davidvillarreal2901/Digital-II/documentacion/diagramas/ArquitecturaSoC.jpg

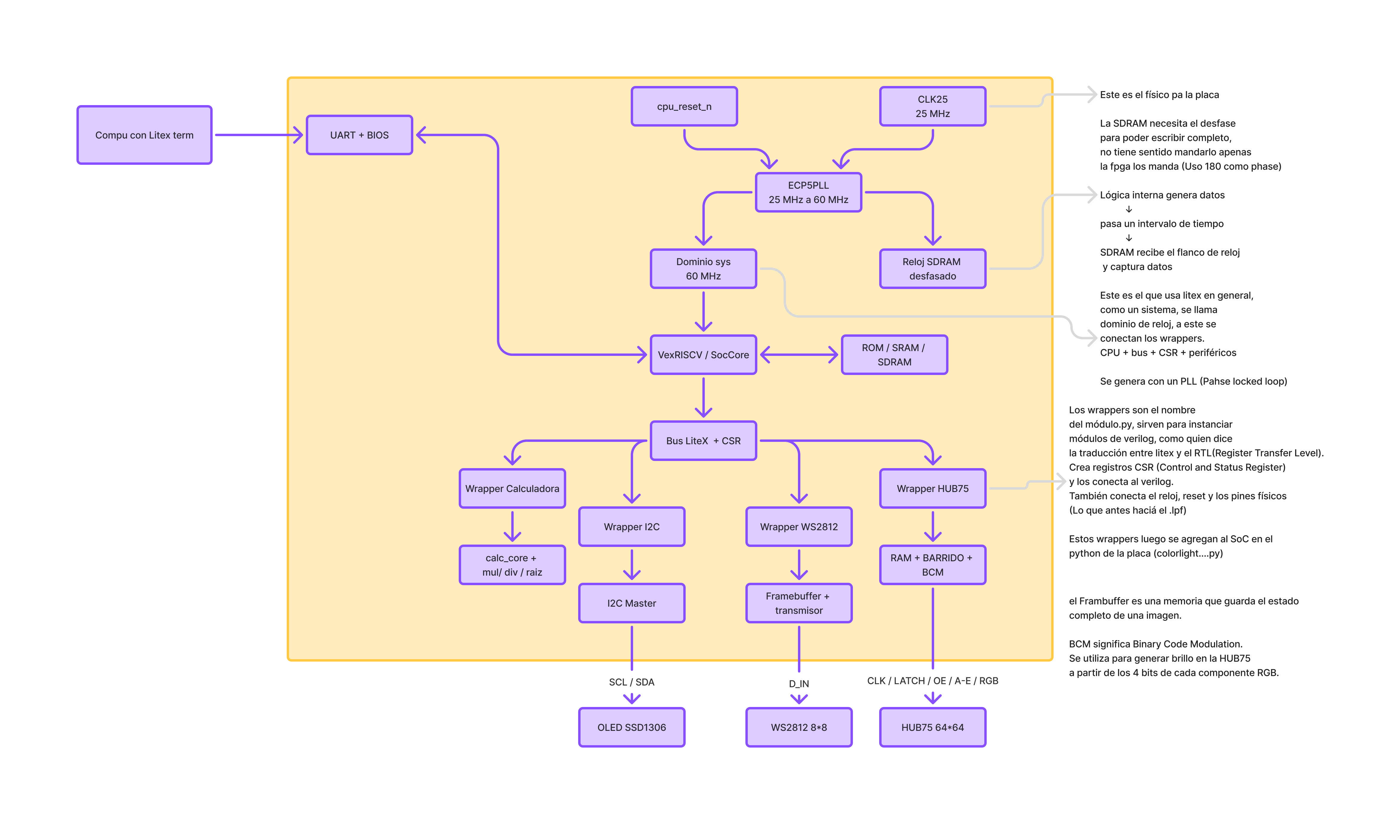
documentacion/diagramas/ArquitecturaSoC.jpg
