davidvillarreal2901/Digital-II/documentacion/diagramas/Calculadora/Calculadora_flujo.jpg

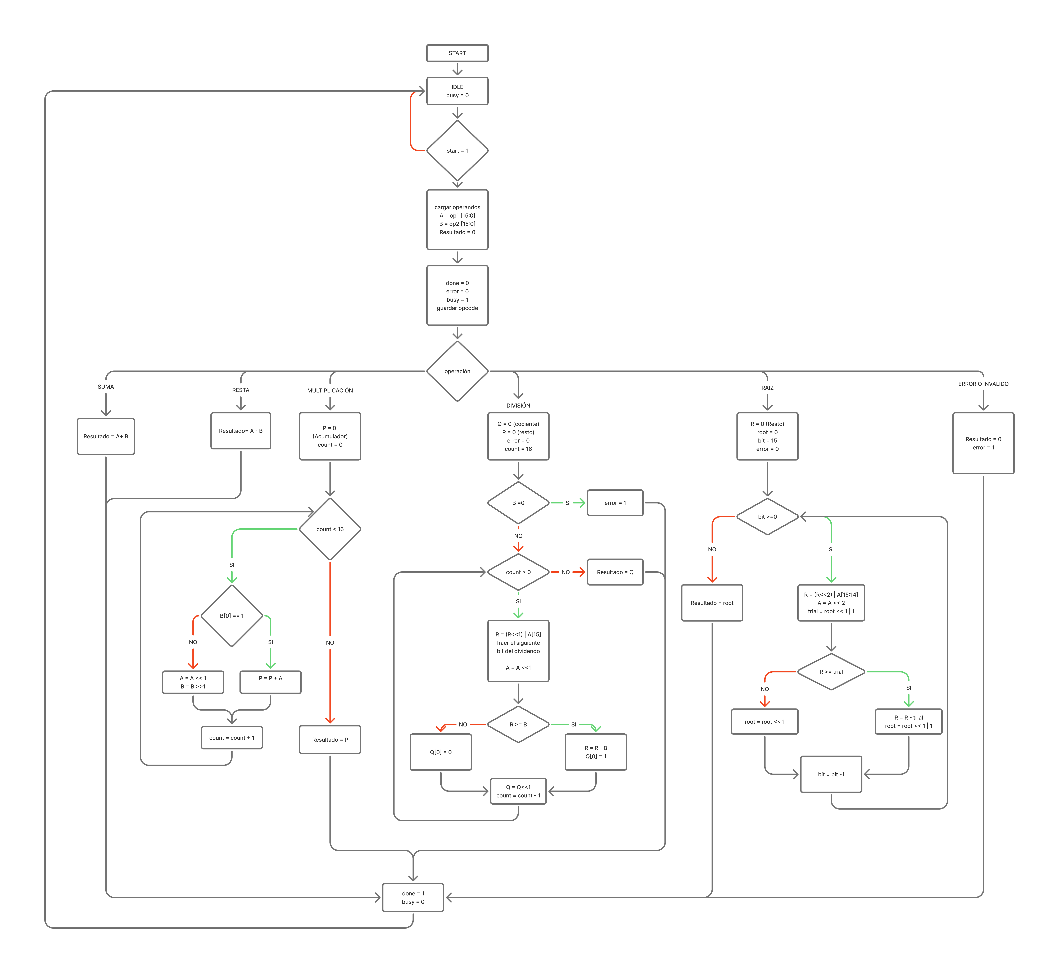
documentacion/diagramas/Calculadora/Calculadora_flujo.jpg
