davidvillarreal2901/Digital-II/documentacion/diagramas/Estructura Repo.jpg

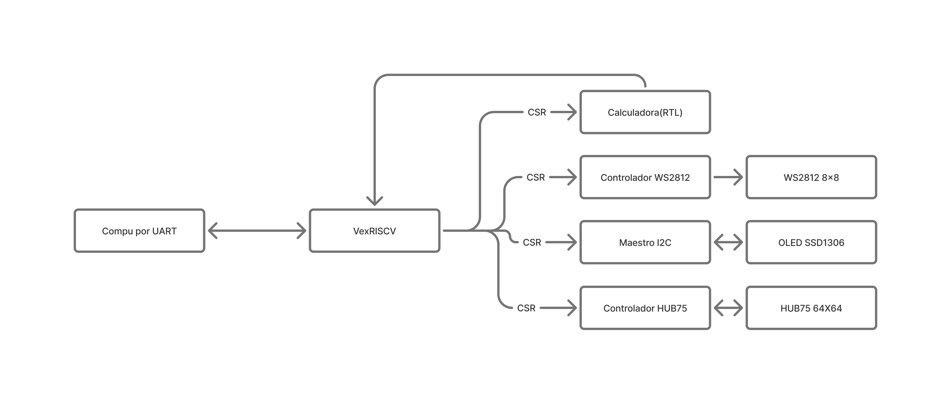
documentacion/diagramas/Estructura Repo.jpg
