davidvillarreal2901/Digital-II/documentacion/diagramas/Flujo firmware interactivo.jpg

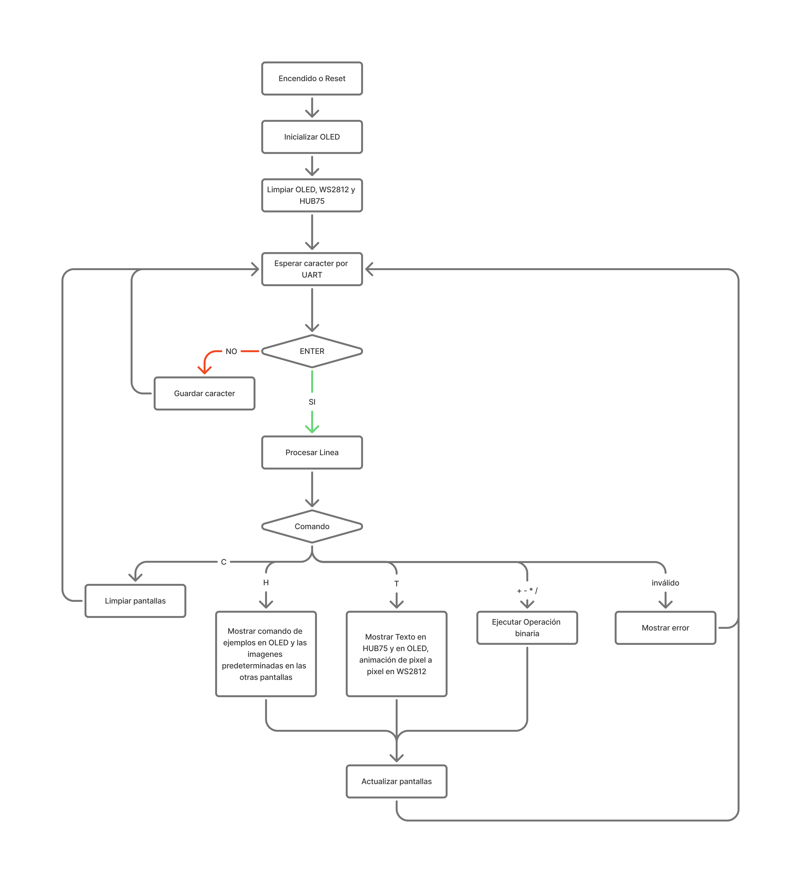
documentacion/diagramas/Flujo firmware interactivo.jpg
