davidvillarreal2901/Digital-II/documentacion/diagramas/I2C/i2c.jpg

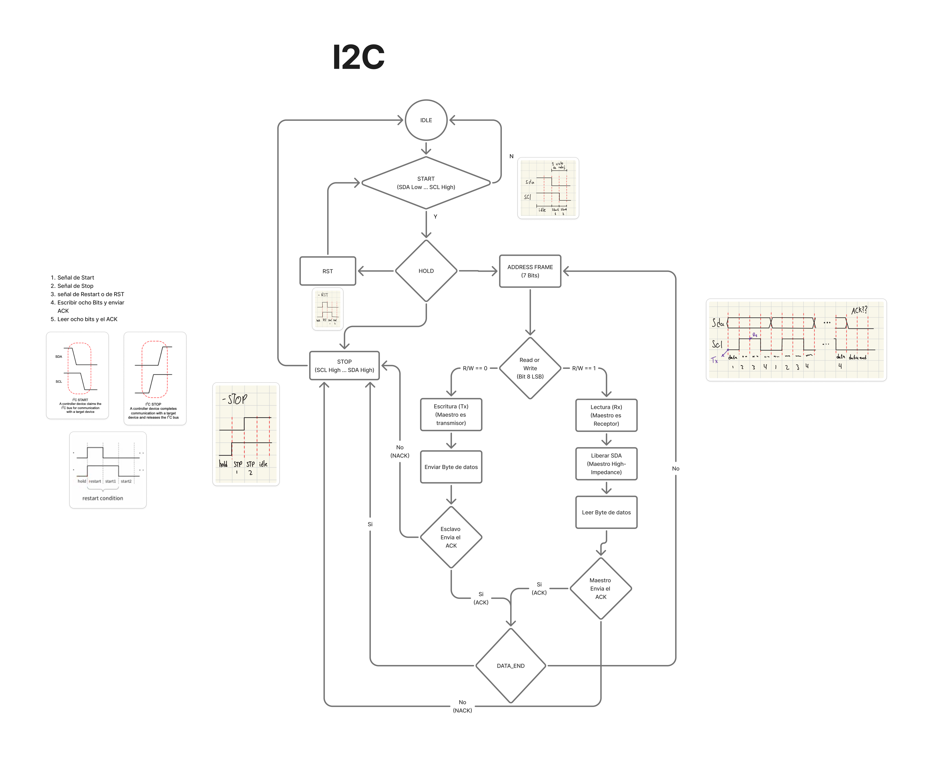
documentacion/diagramas/I2C/i2c.jpg
