davidvillarreal2901/Digital-II/documentacion/diagramas/ws2812/WS2812_estados.jpg

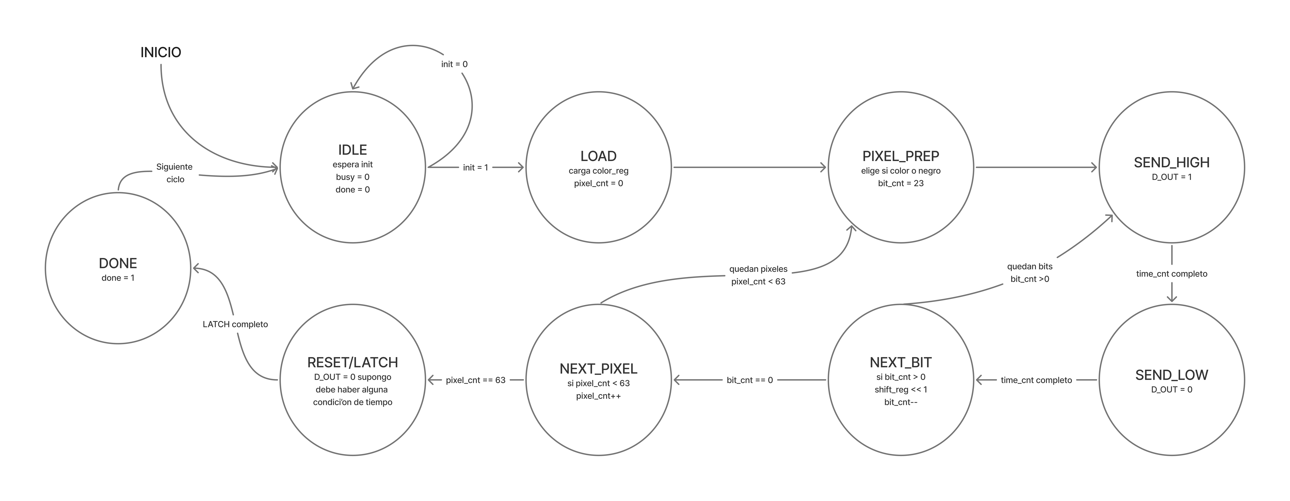
documentacion/diagramas/ws2812/WS2812_estados.jpg
