davidvillarreal2901/Digital-II/documentacion/diagramas/ws2812/WS2812_flujo.jpg

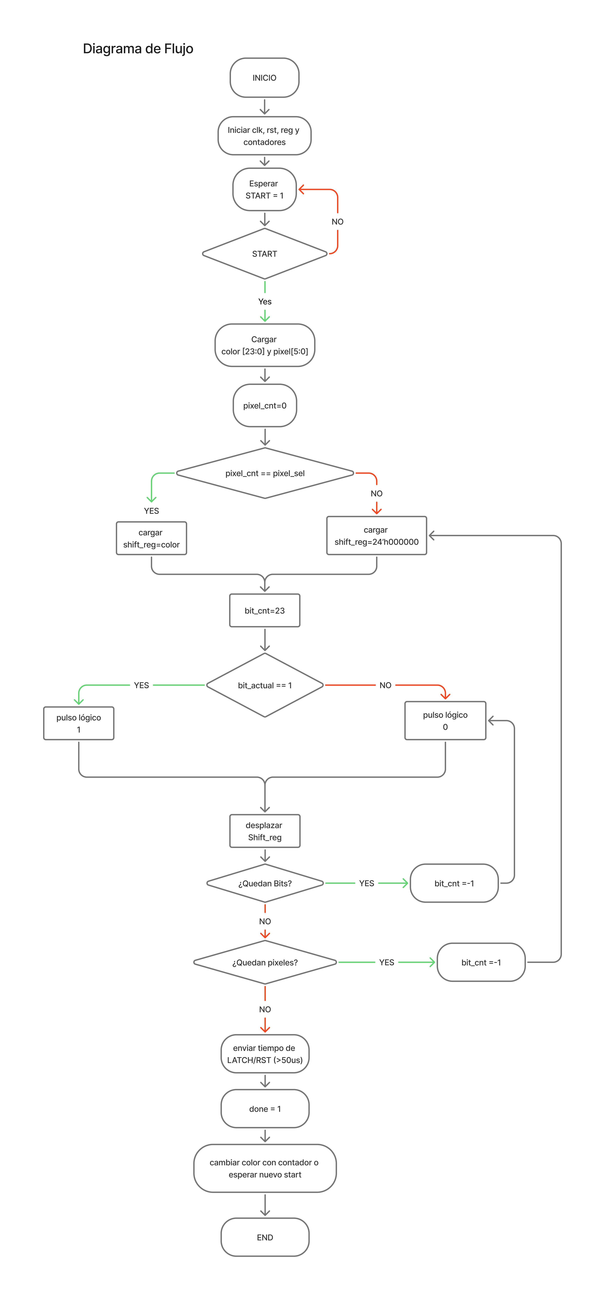
documentacion/diagramas/ws2812/WS2812_flujo.jpg
