davidvillarreal2901/Digital-II/recursos/ws2812/kirby.png

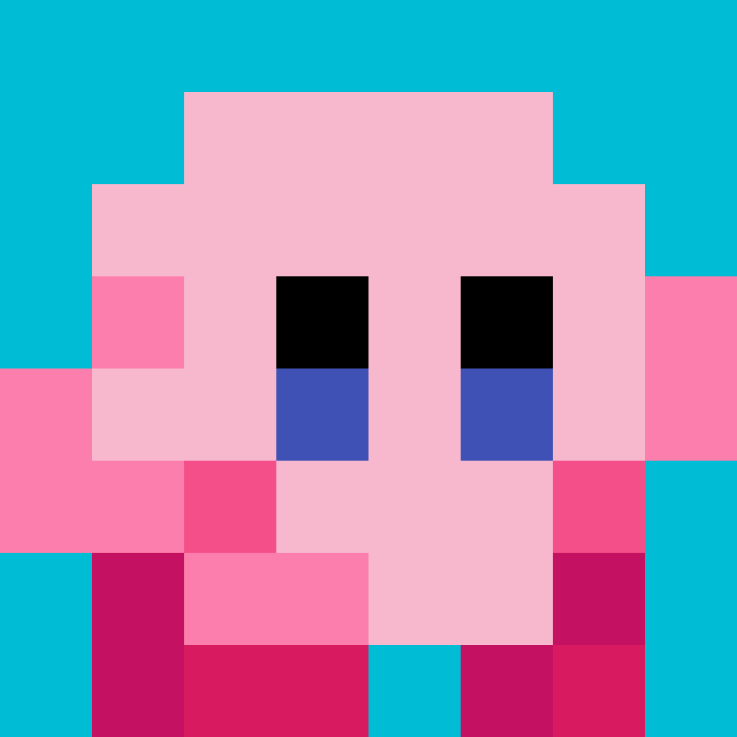
recursos/ws2812/kirby.png
