davidvillarreal2901/Digital-II/firmware/demo_integrada/imagen_ws2812.h

#ifndef IMAGEN_WS2812_H
#define IMAGEN_WS2812_H

#include <stdint.h>

#define IMAGEN_WS2812_WIDTH  8
#define IMAGEN_WS2812_HEIGHT 8
#define IMAGEN_WS2812_PIXELS 64

static const uint32_t imagen_ws2812[64] = {
    0x0E0E0E, 0x000000, 0x000000, 0x05090D, 0x060605, 0x000000, 0x000000, 0x090909,
    0x000000, 0x0E0E0E, 0x05090D, 0x0F0900, 0x0F0900, 0x05090D, 0x0E0E0E, 0x000000,
    0x000000, 0x05090D, 0x060605, 0x030303, 0x030303, 0x060605, 0x05090D, 0x000000,
    0x0F0900, 0x030303, 0x090909, 0x0E0E0E, 0x0E0E0E, 0x0E0E0E, 0x0F0900, 0x030303,
    0x000000, 0x05090D, 0x030303, 0x030303, 0x030303, 0x030303, 0x05090D, 0x000000,
    0x000000, 0x05090D, 0x0E0E0E, 0x0E0E0E, 0x0E0E0E, 0x090909, 0x05090D, 0x000000,
    0x000000, 0x0E0E0E, 0x030303, 0x090909, 0x060605, 0x030303, 0x0E0E0E, 0x000000,
    0x090909, 0x000000, 0x000000, 0x0E0E0E, 0x090909, 0x000000, 0x000000, 0x030303,
};

#endif
