davidvillarreal2901/Digital-II/(commit log)

2026-05-07 Diagramas Flujo, bloques y estado para encender un LED
2026-05-07 Diagrama de flujo corregido, tenía un error de extensión de archivo
2026-07-06 Organización de la estructura final del repo.
2026-07-06 Ahora is organizando la estructura del repo completo
2026-07-08 test(calculadora): agregué el testbench ahora si funcional, cómo costó darme cuenta que tenía que darle más tiempo pa que se borrara el resultado anterior.
2026-07-11 feat(ws2812): integra matriz 8x8 con el test básico de prende rdos leds en orden con litex ya funcional.
2026-07-11 feat(ws2812): integra imágenes estáticas, falta documentar el uso del script de python apra ello.
2026-07-12 feat(i2c): integra oled ssd1306 con LiteX hasta simplemente mostrar un patrón, franjas y limpiar la pantalla.
2026-07-12 feat(integración): Con esta versión funciona calcu+oled+WS2812 manejada desde UART
2026-07-14 feat(Integración): integra calculadora+WS2812+HUB75+I2COLED, todo está funcionando, pero hay limitaciones en duración de gif en ayuda en el hub75, el ws2812 no sé cómo más mejorarlo dado que siento q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
2026-07-15 feat(integración): agregué una demo automática por UART, todo parece funcionar bien, falta subir la documentación y hacer un makefile con comandos más parchados.
2026-07-15 build: agrega demo automatica y comandos de trabajo en un makefile con sentido.
2026-07-15 build: agrega demo automatica y comandos de ejecucion
2026-07-16 build(documentación): ya ahora los diagramas quedaron decentes, agregué un comando también al makefile para las simulñaciones y organicé dónde se guardan los .vcd puse par archivos de documentación, 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
